Tamil-Venthan/esp32-smart-home-hub/agent_docs/01_SYSTEM_ARCHITECTURE.md

# 🏛️ System Architecture Blueprint

## 🌐 High-Level System Overview

The system operates on an **autonomous hybrid IoT architecture** designed to guarantee uninterrupted local home automation even if internet connectivity or the cloud backbone becomes unreachable.

```mermaid
flowchart TD
    subgraph CloudLayer ["1. Cloud Control & Voice Assistants"]
        RMApp["📱 ESP RainMaker App (iOS/Android)"]
        GHome["🗣️ Google Assistant"]
        Alexa["🗣️ Amazon Alexa"]
        RMC["☁️ ESP RainMaker Cloud (AWS IoT Core)"]
        RMApp -->|Secure HTTPS/MQTT| RMC
        GHome -->|Smart Home Skill| RMC
        Alexa -->|Smart Home Skill| RMC
    end

    subgraph ConnectivityBridge ["2. Connectivity Bridge (ESP32)"]
        WiFiSta{"Wi-Fi Available?"}
        OnlineMode["Mode A: Cloud Connected<br>• MQTT Persistent TLS<br>• Real-time State Push<br>• Cloud Schedules & Scenes"]
        OfflineMode["Mode B: Fallback AP Active<br>• SSID: SmartHome_Offline<br>• IP: 192.168.4.1<br>• Dark-Mode Embedded PWA"]
        WiFiSta -- YES --> OnlineMode
        WiFiSta -- NO (>10s) --> OfflineMode
    end

    subgraph MicrocontrollerCore ["3. ESP32 Hub Firmware Core"]
        NVS[("💾 Non-Volatile Storage (NVS)<br>Preferences (Relay States & Labels)")]
        StateEngine["⚡ Unified Relay State Engine"]
        Sensors["🌡️ DHT11 & Internal Die Telemetry"]
        WebServer["🌐 Local WebServer (Port 80)<br>REST API & Web OTA (/update)"]
        
        StateEngine <--> NVS
        OnlineMode <--> StateEngine
        OfflineMode <--> WebServer
        WebServer <--> StateEngine
        Sensors --> StateEngine
    end

    subgraph PhysicalHardware ["4. Physical Hardware & Interfaces"]
        WallSwitches["🔲 4x 230V AC Wall Switches"]
        OptoBoard["⚡ 4-CH PC814 Optocoupler Board<br>(5kV Galvanic Isolation + 50Hz Filter)"]
        RelayBoard["🔌 4-Channel 5V Relay Board<br>(Active LOW Optoisolated)"]
        Loads["💡 Lights, Fans & Domestic Appliances"]
        PowerSupply["⚡ Dual-Rail HLK-10M05 Power Board<br>(220V AC -> 5V @ 2A & 3.3V @ 1A)"]
        
        WallSwitches --> OptoBoard
        OptoBoard --> StateEngine
        StateEngine --> RelayBoard
        RelayBoard --> Loads
        PowerSupply -->|5V Rail| RelayBoard
        PowerSupply -->|3.3V Rail| MicrocontrollerCore
    end

    RMC <--> OnlineMode
```

---

## 🔄 Dual Connectivity Architecture

### Mode A: ESP RainMaker Cloud (Online Mode)
1. **Protocol:** MQTT over Mutual TLS (Port 8883) connecting to AWS IoT Core endpoints hosted by Espressif.
2. **Provisioning:**
   - Supported via Wi-Fi Provisioning over BLE (Bluetooth Low Energy) or SoftAP.
   - Proof of Possession (PoP): `smart123` (configured in `config.h`).
   - Generates persistent node ID on the RainMaker cloud.
3. **Features Enabled:**
   - Worldwide 4G/5G mobile control without port forwarding or dynamic DNS.
   - Google Home and Amazon Alexa smart home integration.
   - Timezone-synced local RTC clock for on-device timers that execute even if the cloud momentarily disconnects.
   - Custom parameters: `Temperature`, `Humidity`, `Die Temp`, `WiFi Signal`.

### Mode B: Automated Fallback Offline Portal (Local Mode)
1. **Trigger Condition:** Wi-Fi router or mobile hotspot connection lost for > 10 seconds.
2. **Access Point Credentials:**
   - **SSID:** `SmartHome_Offline`
   - **Password:** `12345678`
   - **Default Gateway IP:** `192.168.4.1`
   - **mDNS Hostname:** `http://smarthome.local/`
3. **Embedded PWA Dashboard:**
   - Stored directly in ESP32 Flash memory (`PROGMEM`) — requires NO external SD card or LittleFS flash partitions.
   - Fully responsive dark-mode UI with dynamic SVG toggles, live DHT11 telemetry gauges, master switches ("All ON", "All OFF"), and inline switch renaming.
4. **Auto-Recovery:**
   - The ESP32 continuously scans for the configured Wi-Fi credentials in the background. Once the home router or hotspot is turned back on, the ESP32 automatically disconnects the fallback AP and reconnects to RainMaker cloud within seconds.

---

## 🔁 2-Way State Synchronization Model

The system ensures that **no matter which interface** toggles a load (physical wall switch, smartphone app, Google Home voice command, local web browser, or physical BOOT button), all states remain 100% in sync:

```
[Physical Wall Switch] ──► [Optocoupler] ──┐
                                           │
[RainMaker Mobile App] ──► [AWS Cloud] ────┼──► [Relay State Engine] ──► [Physical Relay]
                                           │               │
[Offline Web Portal]   ──► [HTTP REST] ────┤               ▼
                                           │      [NVS Flash Memory]
[BOOT Push Button]     ──► [GPIO 0] ───────┘      (Survives Power Loss)
```

1. **Physical Wall Switch:** Toggling an AC wall switch alters the optical signal across the PC814 optocoupler. The firmware's debounced edge detector identifies the transition and toggles the corresponding relay channel.
2. **Instant Cloud & Web Feedback:** The `StateEngine` updates the hardware pin, commits the new boolean state to Non-Volatile Storage (`Preferences`), and immediately reports the new state to both the RainMaker cloud parameter and local HTTP clients.
3. **Power Outage Resilience:** When mains power is restored after a blackout, `main.cpp` reads the stored states from NVS namespace `"relays"` and immediately returns every relay to its exact pre-blackout state within 15 milliseconds.

---

## ⚡ Over-The-Air (OTA) Firmware Updates

The ESP32-WROOM production build incorporates a dual-partition OTA engine:
- **Partition Scheme:** `ota_0` (1.8MB) and `ota_1` (1.8MB) managed via `partitions_wroom_4MB.csv`.
- **Web Interface:** Accessible via browser at `http://<ESP32-IP>/update` or `http://192.168.4.1/update`.
- **Security:** Standard HTTP POST handler with flash boundary verification and automatic rollback if flashing is interrupted or corrupted.
