Tamil-Venthan/esp32-smart-home-hub/firmware/esp32_wroom_production/rainmaker_qr.png

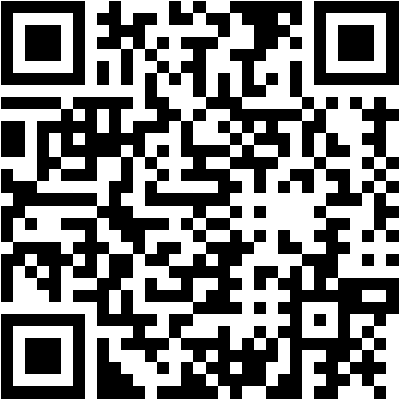
firmware/esp32_wroom_production/rainmaker_qr.png
