Tamil-Venthan/esp32-smart-home-hub/hardware/5v_power_supply_module/renders/pcb_bottom.png

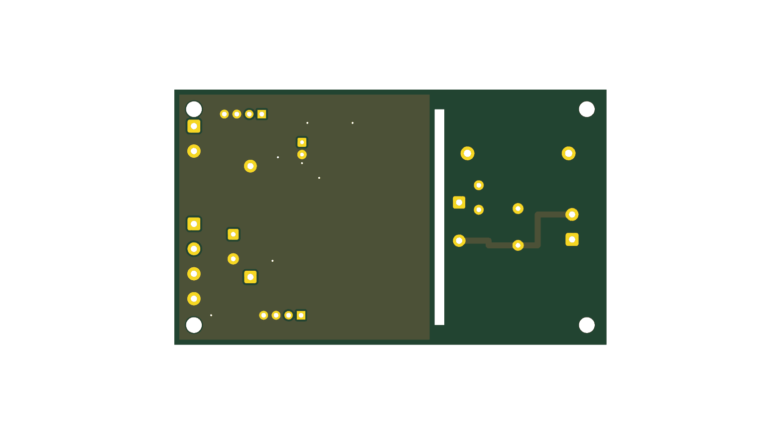
hardware/5v_power_supply_module/renders/pcb_bottom.png
