Tamil-Venthan/esp32-smart-home-hub/hardware/5v_power_supply_module/renders/pcb_isometric_3d.png

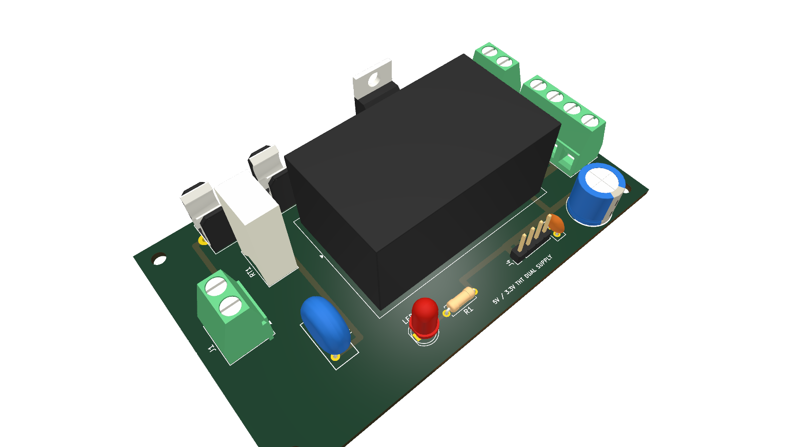
hardware/5v_power_supply_module/renders/pcb_isometric_3d.png
