Tamil-Venthan/esp32-smart-home-hub/hardware/5v_power_supply_module/renders/pcb_rear_3d.png

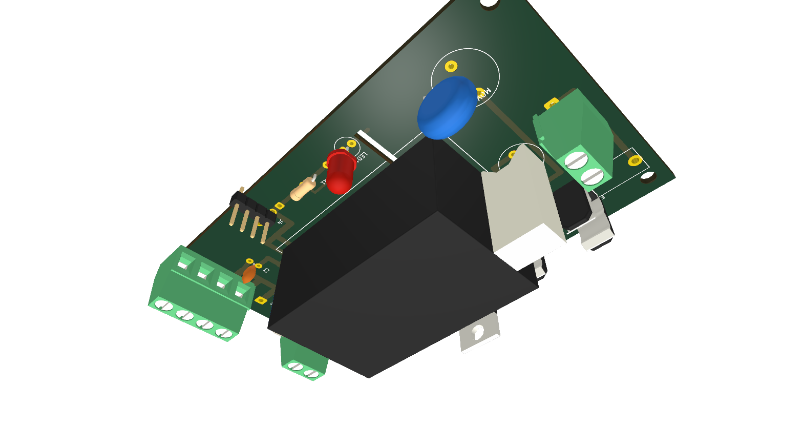
hardware/5v_power_supply_module/renders/pcb_rear_3d.png
