Tamil-Venthan/esp32-smart-home-hub/hardware/optocoupler_4ch_module/renders/pcb_render_bottom_tht.png

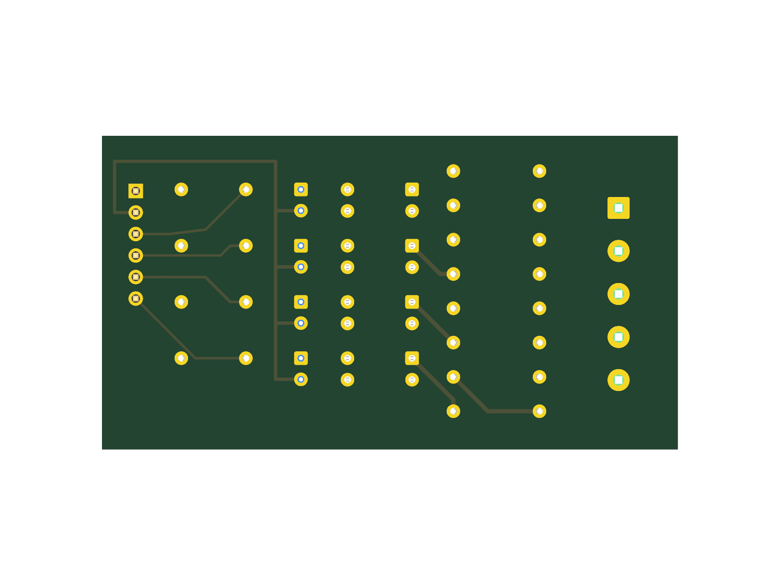
hardware/optocoupler_4ch_module/renders/pcb_render_bottom_tht.png
