Tamil-Venthan/esp32-smart-home-hub/hardware/optocoupler_4ch_module/renders/pcb_render_top.png

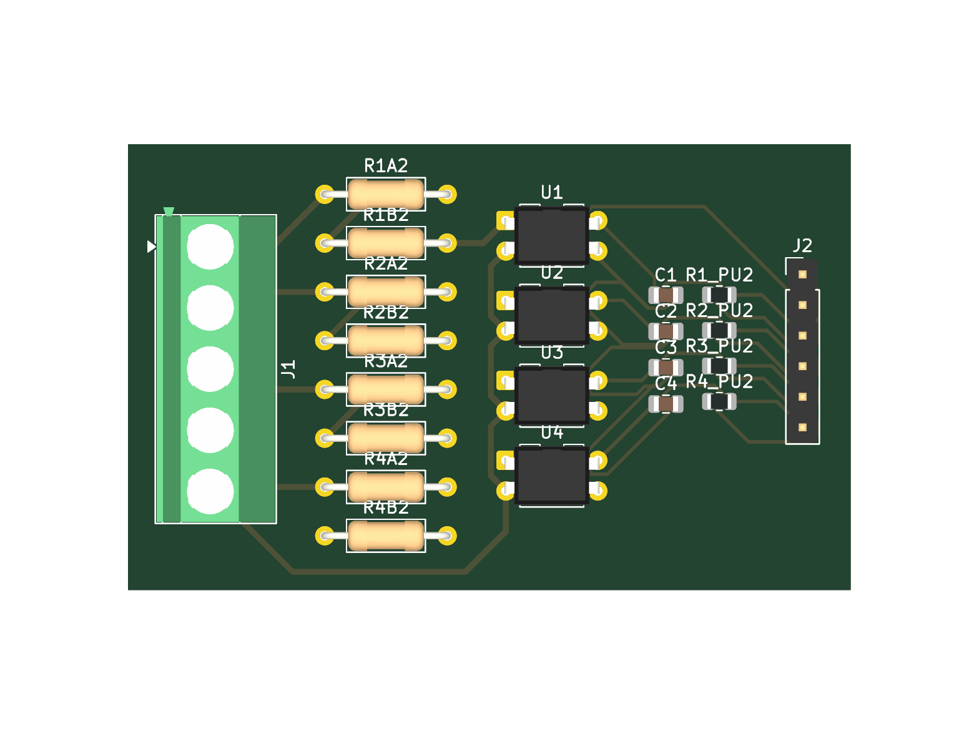
hardware/optocoupler_4ch_module/renders/pcb_render_top.png
