Tamil-Venthan/esp32-smart-home-hub/hardware/optocoupler_4ch_module/production/BOM_Optocoupler_4CH_JLCPCB.csv

Comment | Designator | Footprint | LCSC Part # | MPN | Quantity | Package
10uF | C1, C2, C3, C4 | C_0805_2012Metric | C15850 | CL21A106KOQNNNE | 4 | 0805
10k | R1_PU2, R2_PU2, R3_PU2, R4_PU2 | R_0805_2012Metric | C17414 | RC0805JR-0710KL | 4 | 0805
PC814 | U1, U2, U3, U4 | DIP-4_W7.62mm | C75881 | PC814X1J000F | 4 | DIP-4
100k 0.5W | R1A2, R1B2, R2A2, R2B2, R3A2, R3B2, R4A2, R4B2 | Axial_DIN0207_P10.16mm | C174822 | MF0207FTE52-100K | 8 | Axial DIN0207
AC_MAINS_INPUT (5-Pin 5.08mm) | J1 | TerminalBlock_5.08mm_1x05 | C8449 | XY2500V-A-5.08-5P | 1 | 5.08mm Pitch
ESP32_INTERFACE (6-Pin 2.54mm) | J2 | PinHeader_1x06_P2.54mm | C22550 | 2.54-1x6P-Header | 1 | 2.54mm Pitch
