Tamil-Venthan/esp32-smart-home-hub/hardware/5v_power_supply_module/5V_Power_Supply_Schematic.pdf

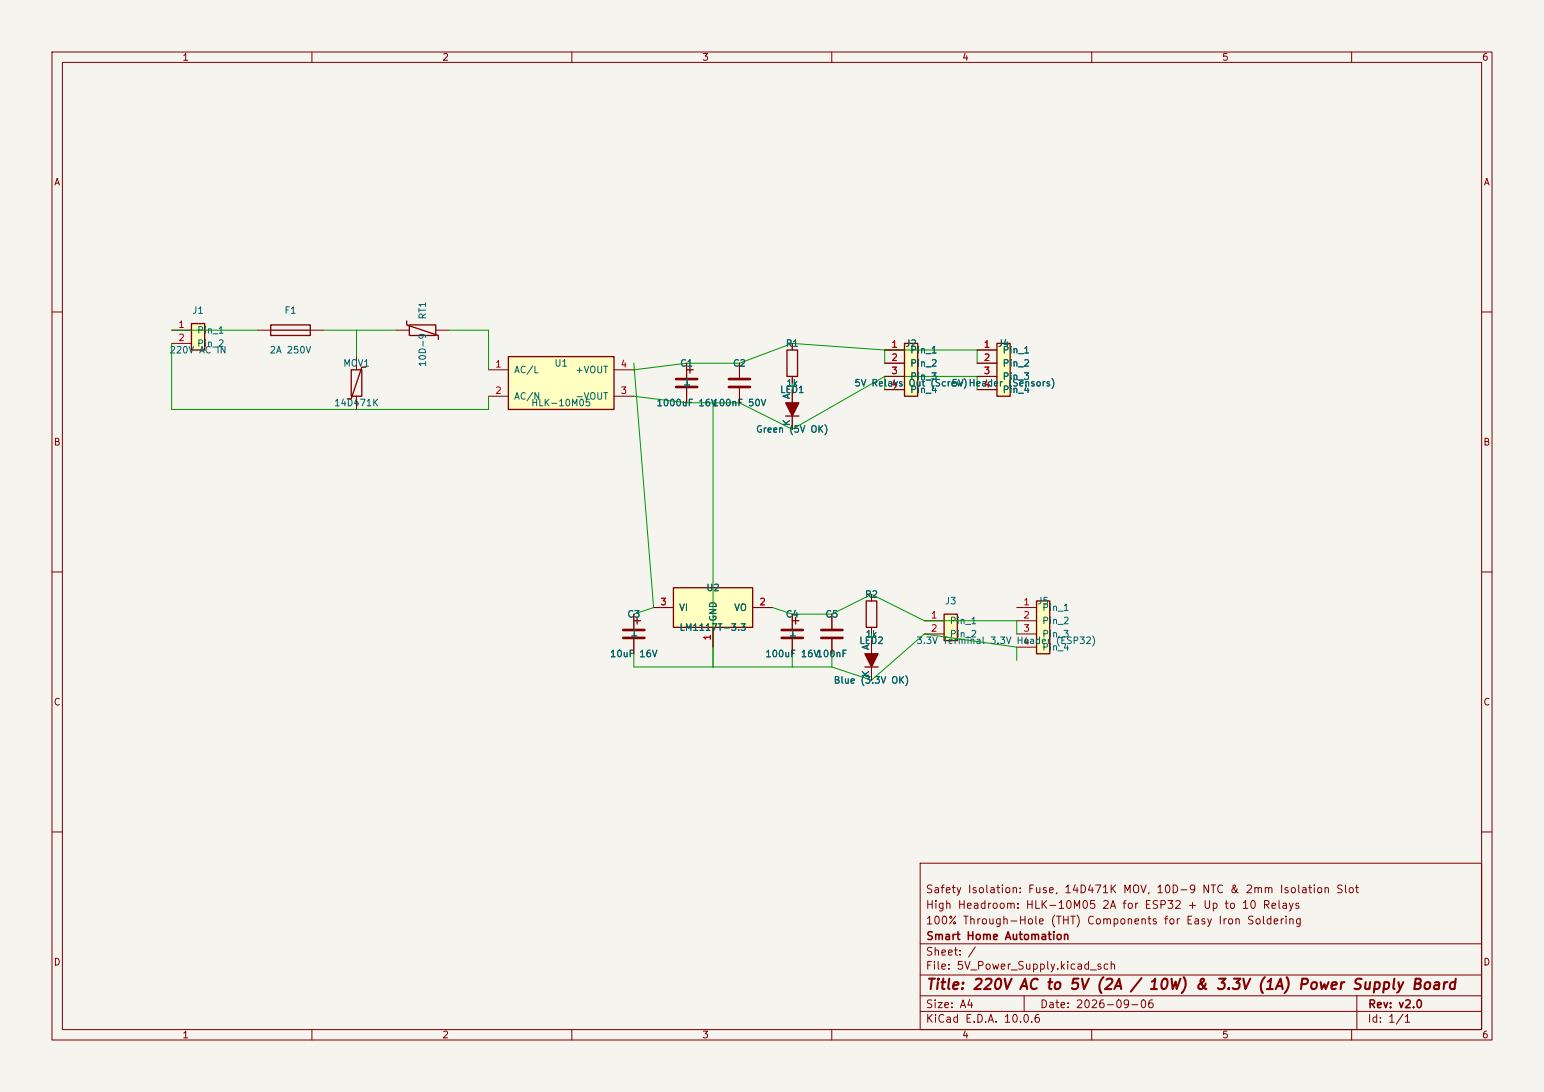
[picture p13: page 1]

Safety Isolation: Fuse, 14D471K MOV, 10D-9 NTC & 2mm Isolation Slot
High Headroom: HLK-10M05 2A for ESP32 + Up to 10 Relays
100% Through-Hole (THT) Components for Easy Iron Soldering
Smart Home Automation
Sheet: /
File: 5V_Power_Supply.kicad_sch
Title: 220V AC to 5V (2A / 10W) & 3.3V (1A) Power Supply Board

Size: A4 | Rev: v2.0
KiCad E.D.A. 10.0.6 | Id: 1/1
