Tamil-Venthan/esp32-smart-home-hub/hardware/5v_power_supply_module/5V_Power_Supply.kicad_pcb

## KiCad design hardware/5v_power_supply_module/5V_Power_Supply.kicad_pcb (2026-11-02)

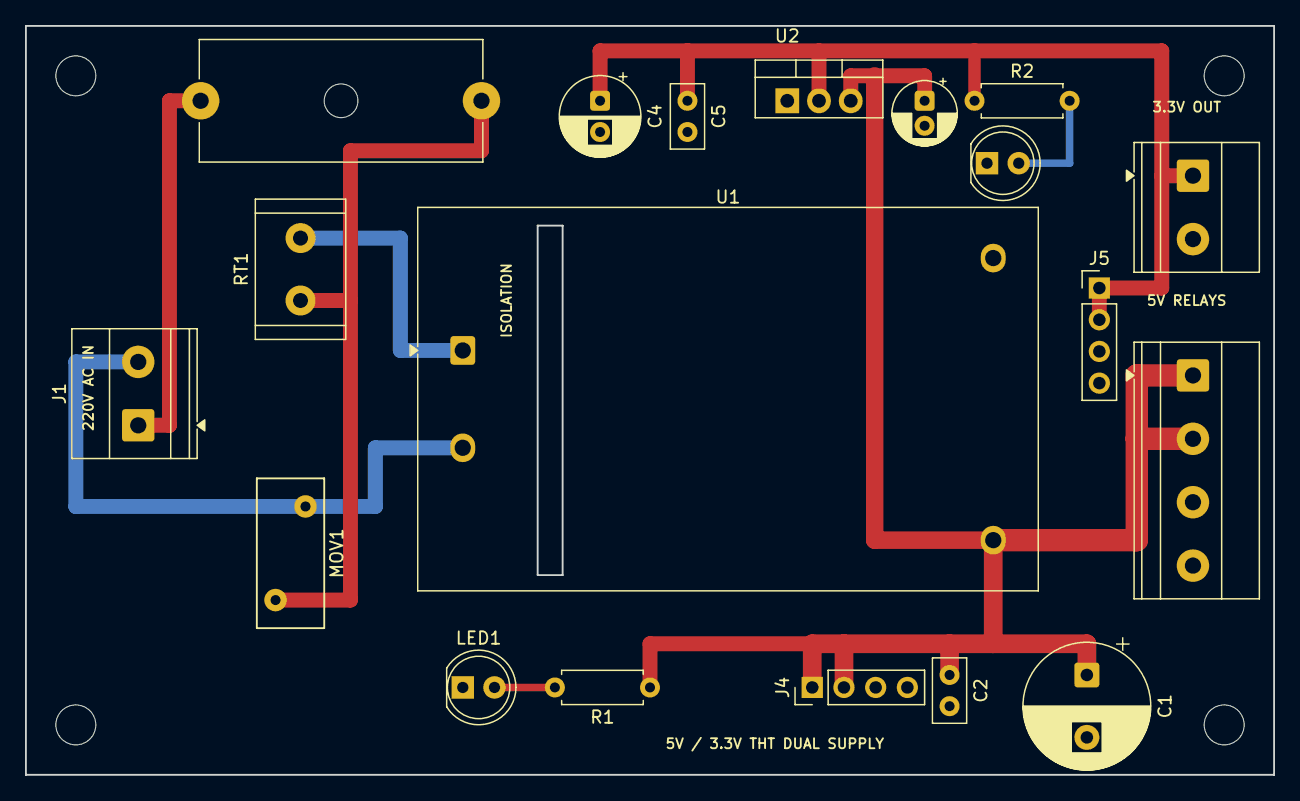
[picture p14: board 5V_Power_Supply.kicad_pcb from above]

Board: 2 copper layers, 100.0 x 60.0 mm, 23 parts (0 on the bottom side), 9 nets.

Parts:
C1: 1000uF; CP_Radial_D10.0mm_P5.00mm
C2, C5: 100nF; C_Disc_D5.0mm_W2.5mm_P2.50mm
C3: 10uF; CP_Radial_D5.0mm_P2.00mm
C4: 100uF; CP_Radial_D6.3mm_P2.50mm
F1: 2A_250V; Fuseholder_Cylinder-5x20mm_Schurter_0031_8201_Horizontal_Op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
H1, H2, H3, H4: M3; MountingHole_3.2mm_M3
J1: 220V_AC_IN; TerminalBlock_Phoenix_MKDS-1,5-2-5.08_1x02_P5.08mm_Horizont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
J2: 5V_OUT; TerminalBlock_Phoenix_MKDS-1,5-4-5.08_1x04_P5.08mm_Horizont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
J3: 3.3V_OUT; TerminalBlock_Phoenix_MKDS-1,5-2-5.08_1x02_P5.08mm_Horizont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
J4: 5V_HDR; PinHeader_1x04_P2.54mm_Vertical
J5: 3.3V_HDR; PinHeader_1x04_P2.54mm_Vertical
LED1: 5V_OK; LED_D5.0mm
LED2: 3.3V_OK; LED_D5.0mm
MOV1: 14D471K; RV_Disc_D12mm_W5.4mm_P7.5mm
R1, R2: 1k; R_Axial_DIN0207_L6.3mm_D2.5mm_P7.62mm_Horizontal
RT1: 10D-9; R_Radial_Power_L11.0mm_W7.0mm_P5.00mm
U1: HLK-10M05; Converter_ACDC_Hi-Link_HLK-10Mxx
U2: LM1117T-3.3; TO-220-3_Vertical

Connections:
+3V3: C4.1, C5.1, J3.1, J5.1, J5.2, R2.1, U2.2
+5V: C1.1, C2.1, C3.1, J2.1, J2.2, J4.1, J4.2, R1.1, U1.4, U2.3
AC_L: F1.1, J1.1
AC_L_FUSED: F1.2, MOV1.1, RT1.1
AC_L_IN: RT1.2, U1.1
AC_N: J1.2, MOV1.2, U1.2
GND: C1.2, C2.2, C3.2, C4.2, C5.2, J2.3, J2.4, J3.2, J4.3, J4.4, J5.3, J5.4, LED1.1, LED2.1, U1.3, U2.1
unnamed: LED1.2, R1.2
unnamed: LED2.2, R2.2
