Tamil-Venthan/esp32-smart-home-hub/hardware/optocoupler_4ch_module/Optocoupler_4CH.kicad_pcb

## KiCad design hardware/optocoupler_4ch_module/Optocoupler_4CH.kicad_pcb (2026-11-02)

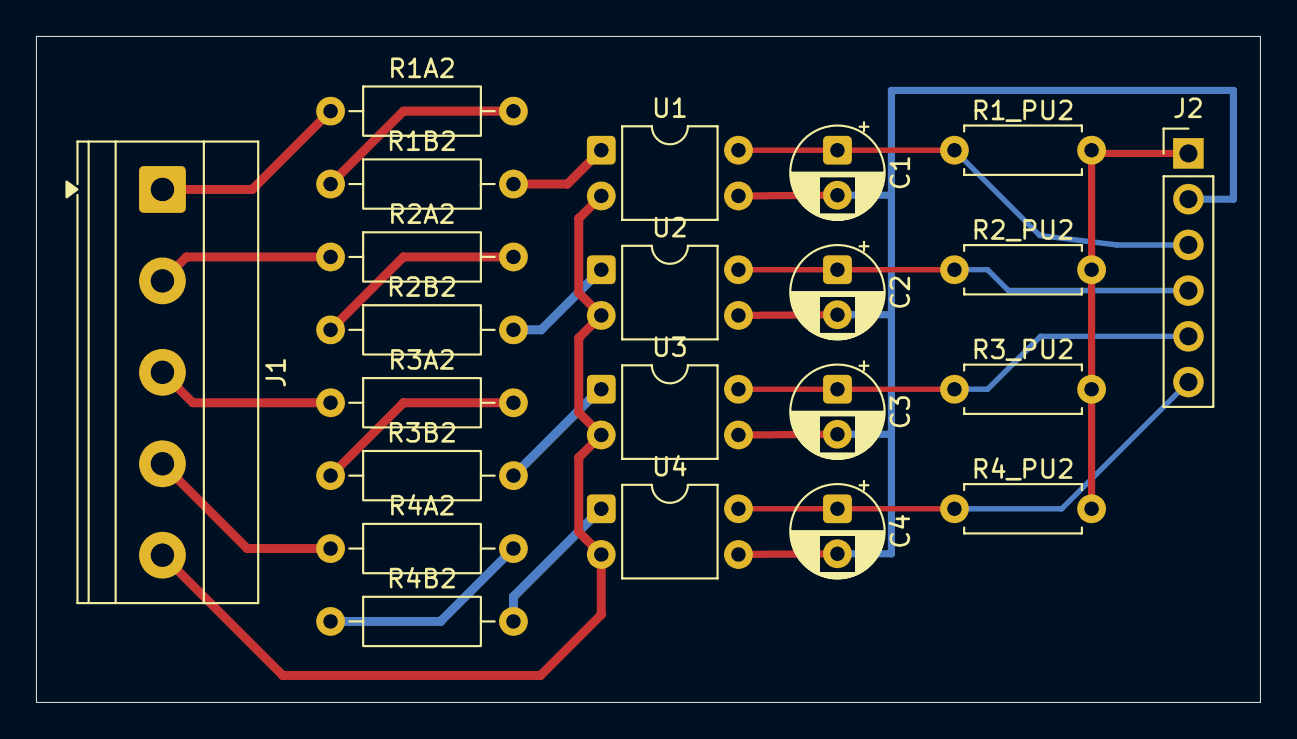
[picture p15: board Optocoupler_4CH.kicad_pcb from above]

Board: 2 copper layers, 68.0 x 37.0 mm, 22 parts (0 on the bottom side), 19 nets.

Parts:
C1, C2, C3, C4: 10uF; CP_Radial_D5.0mm_P2.50mm
J1: AC_MAINS_INPUT; TerminalBlock_Phoenix_MKDS-1,5-5-5.08_1x05_P5.08mm_Horizont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
J2: ESP32_INTERFACE; PinHeader_1x06_P2.54mm_Vertical
R1A2, R1B2, R2A2, R2B2, R3A2, R3B2, R4A2, R4B2: 100k_0.5W; R_Axial_DIN0207_L6.3mm_D2.5mm_P10.16mm_Horizontal
R1_PU2, R2_PU2, R3_PU2, R4_PU2: 10k; R_Axial_DIN0207_L6.3mm_D2.5mm_P7.62mm_Horizontal
U1, U2, U3, U4: PC814; DIP-4_W7.62mm

Connections:
+3V3: J2.1, R1_PU2.2, R2_PU2.2, R3_PU2.2, R4_PU2.2
/AC_N: J1.5, U1.2, U2.2, U3.2, U4.2
/OUT1: C1.1, J2.3, R1_PU2.1, U1.4 (C)
/OUT2: C2.1, J2.4, R2_PU2.1, U2.4 (C)
/OUT3: C3.1, J2.5, R3_PU2.1, U3.4 (C)
/OUT4: C4.1, J2.6, R4_PU2.1, U4.4 (C)
/SW1: J1.1, R1A2.1
/SW2: J1.2, R2A2.1
/SW3: J1.3, R3A2.1
/SW4: J1.4, R4A2.1
GND: C1.2, C2.2, C3.2, C4.2, J2.2, U1.3 (E), U2.3 (E), U3.3 (E), U4.3 (E)
unnamed: R1A2.2, R1B2.1
unnamed: R1B2.2, U1.1
unnamed: R2A2.2, R2B2.1
unnamed: R2B2.2, U2.1
unnamed: R3A2.2, R3B2.1
unnamed: R3B2.2, U3.1
unnamed: R4A2.2, R4B2.1
unnamed: R4B2.2, U4.1
