Tamil-Venthan/esp32-smart-home-hub/(commit log)

2026-11-02 Initial commit: Production ESP32 Smart Home System with KiCad Hardware, Dual-Platform Firmware, and AI Agent Knowledge Base
    [5V_Power_Supply-B_Cu.gbl, 5V_Power_Supply-B_Mask.gbs, 5V_Power_Supply-B_Paste.gbp, 5V_Power_Supply-B_Silkscreen.gbo, 5V_Power_Supply-Edge_Cuts.gm1, 5V_Power_Supply-F_Cu.gtl, 5V_Power_Supply-F_Mask.gts, 5V_Power_Supply-F_Paste.gtp]
2026-11-02 Add MIT License and comprehensive 230V AC Mains Electrical Safety Disclaimer
